SmartLoo/HW/Resources/SmartLooBOM.xlsx

Component | Quantity | Description | Link
PCB:
Capacitor
10uF 0603 Capacitor | 5 | Capacitor | https://www.mouser.com/ProductDetail/963-JMK107BJ106MA-T
.1uF 0603 Capacitor | 4 | Capacitor | https://www.mouser.com/ProductDetail/77-VJ0603Y104MXQCBC
Connector
Xbee Female Connector | 2 | XBee interface connector | https://www.mouser.com/ProductDetail/855-M22-7131042
IC
ATMEGA328P-AU | 1 | Microprocessor | https://www.mouser.com/ProductDetail/556-ATMEGA328P-AUR
MIC5205 | 1 | 3.3V regulator | https://www.mouser.com/ProductDetail/998-MIC5205-3.3YM5TR
TPS61202 | 1 | 5V Switching Regulator | https://www.mouser.com/ProductDetail/595-TPS61202DRCR
Inductor
2.2uH 1210 | 1 | Inductor | https://www.mouser.com/ProductDetail/81-1226AS-H-2R2MP2
Resistor
10k 0603 Resistor | 2 | Resistor | https://www.mouser.com/ProductDetail/755-ESR03EZPJ103
Resonator
8MHz Resonator | 1 | Resonator | https://www.mouser.com/ProductDetail/81-CSTCE8M00GH5C99R0
Sensor Node:
Enclosure
Plastic Enclosure | 1 | Plastic Enclosure | https://www.amazon.com/gp/product/B073Y7FW1Q/ref=oh_aui_detailpage_o02_s00?ie=UTF8&psc=1
Sensors
HC-SR04 | 1 | Ultrasonic Sensor | https://www.amazon.com/Keywish-HC-SR04-Ultrasonic-Duemilanove-Raspberry/dp/B071W9689R?s=hi
Grove Water Sensor | 1 | Grove Water Sensor | https://www.amazon.com/SeeedStudio-Grove-Sensor-Source-BOOOLE/dp/B00VY9W806
Wiring Harness
2x3 Position Male Header | 1 | Male Connector | https://www.digikey.com/product-detail/en/M20-9720345/952-1921-ND/3727888?so=54298428
2x3 Position Female Header | 1 | Female Connector | https://www.digikey.com/product-detail/en/PPPC032LFBN-RC/S7106-ND/810243?so=54298428
6 Conductor 24 AWG Wiring | 1' | Wiring Connector | https://www.digikey.com/product-detail/en/30-00507/T1346-5-ND/6245014?so=54298428
XBee
XBee S2C | 1 | XBee S2C Radio Module | https://www.digikey.com/product-detail/en/digi-international/XB24CAWIT-001/602-1891-ND/6010100
