SmartLoo/HW/Resources/EAGLE/LooSensorNodeV2/LooSensorNodeV2_Schematic/LooSensorNodeV2_Page1.pdf

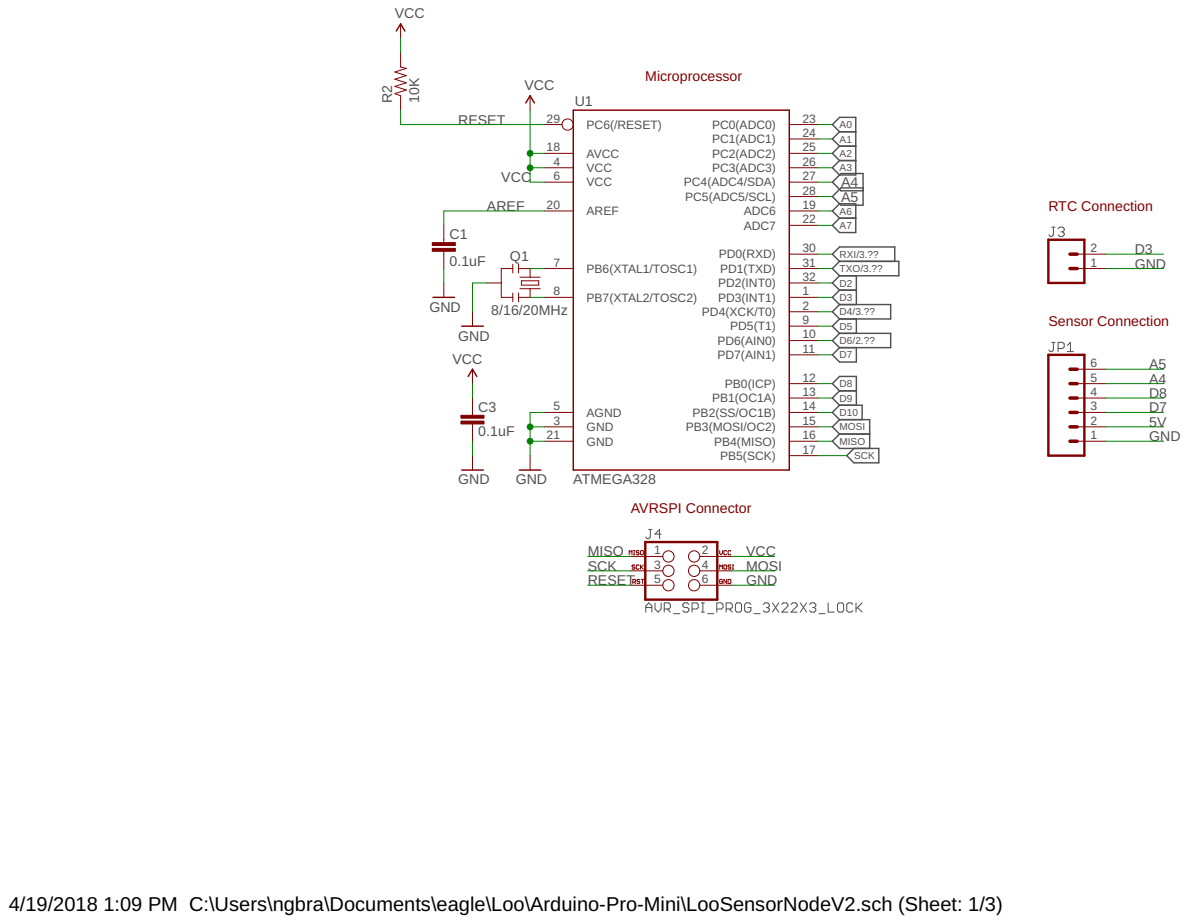
[picture p4: page 1]

4/19/2018 1:09 PM C:\Users\ngbra\Documents\eagle\Loo\Arduino-Pro-Mini\LooSensorNodeV2.sch (Sheet: 1/3)
