SmartLoo/HW/Resources/EAGLE/LooSensorNodeV2/LooSensorNodeV2_Schematic/LooSensorNodeV2_Page2.pdf

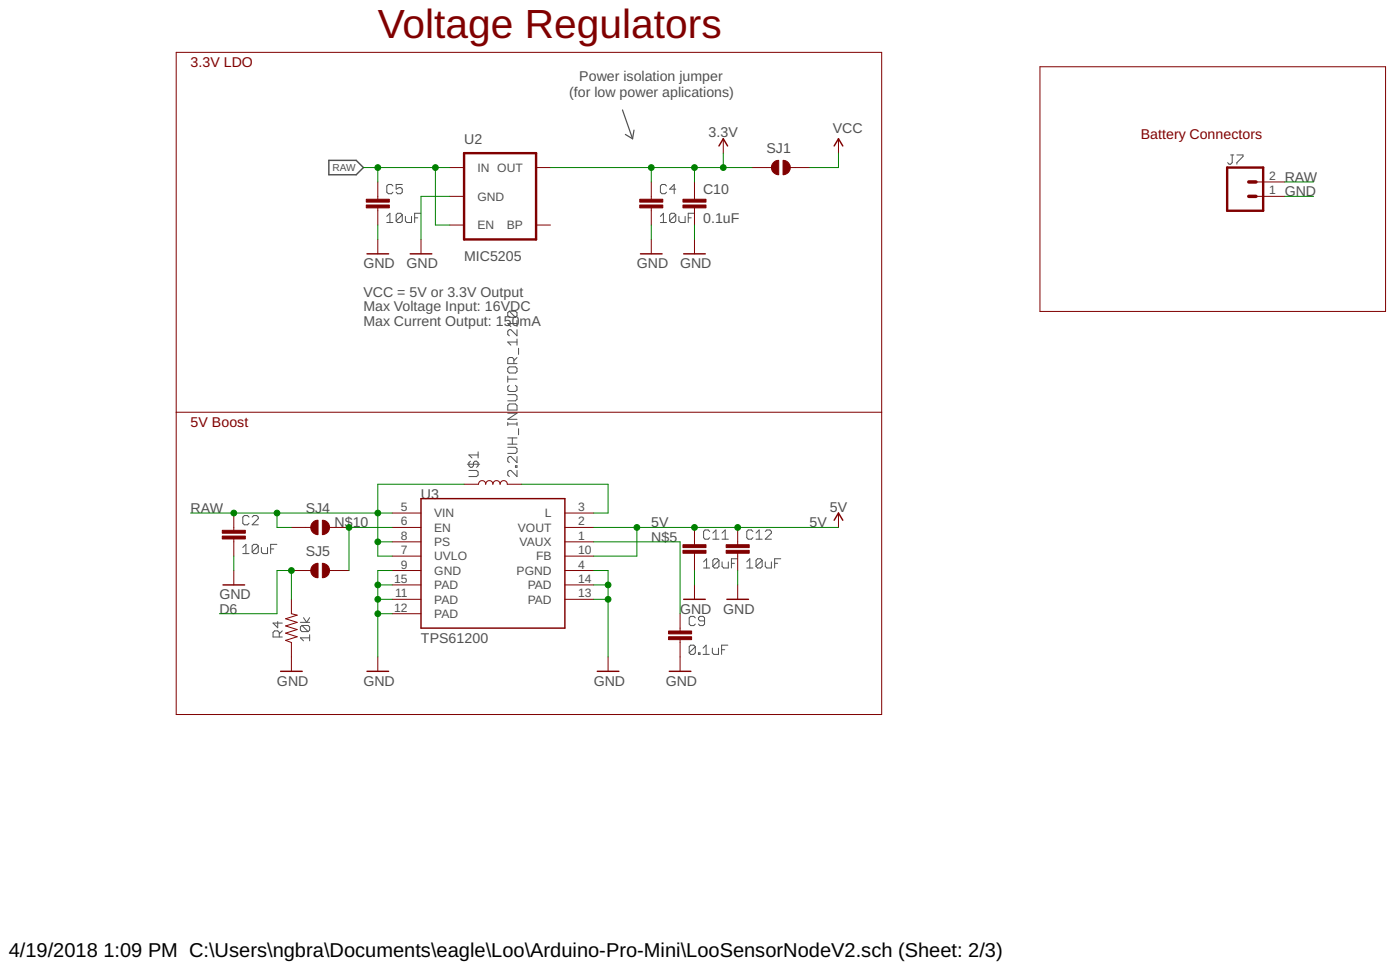
[picture p5: page 1]

Power isolation jumper
(for low power aplications)

GND GND MIC5205 GND GND

4/19/2018 1:09 PM C:\Users\ngbra\Documents\eagle\Loo\Arduino-Pro-Mini\LooSensorNodeV2.sch (Sheet: 2/3)
