SmartLoo/HW/Resources/EAGLE/LooSensorNodeV2/LooSensorNodeV2_Layout.pdf

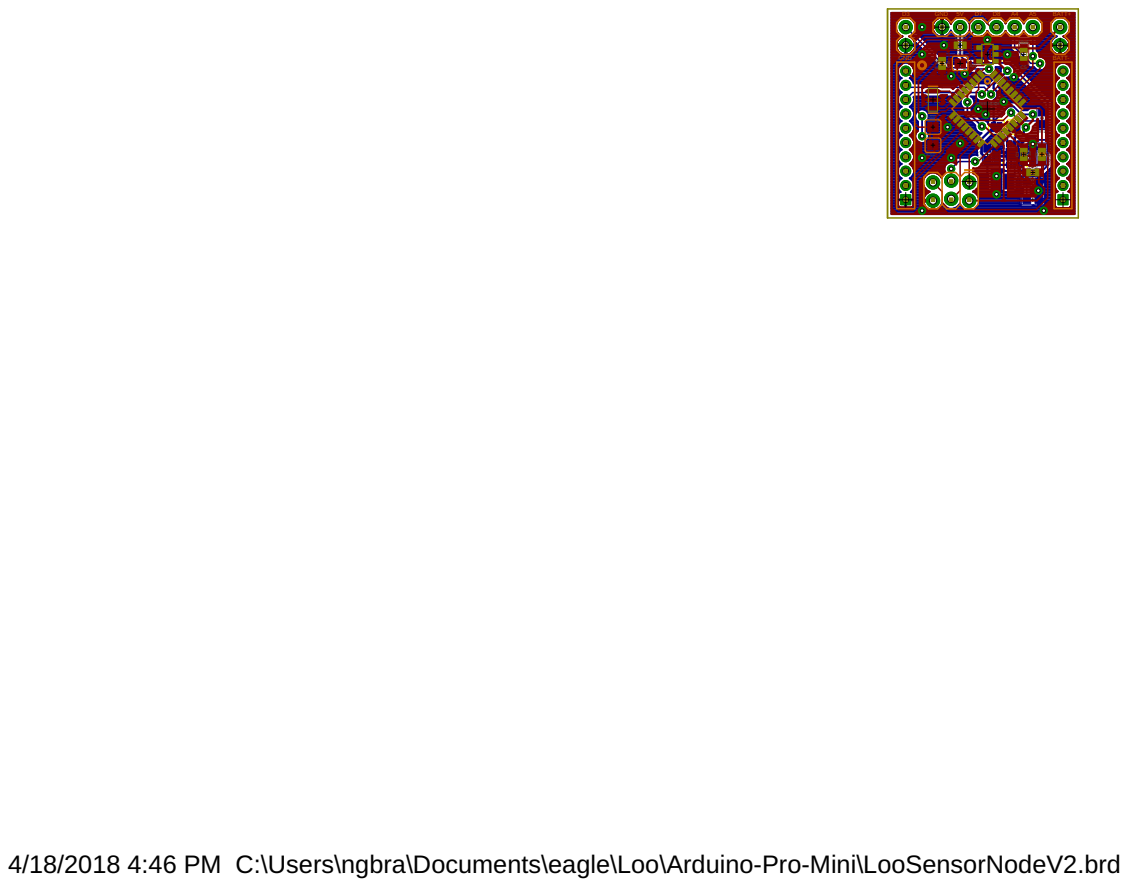
[picture p6: page 1]

4/18/2018 4:46 PM C:\Users\ngbra\Documents\eagle\Loo\Arduino-Pro-Mini\LooSensorNodeV2.brd
