SmartLoo/HW/Resources/EAGLE/LooSensorNodeV0/LooSensorNodeV0Schematic.pdf

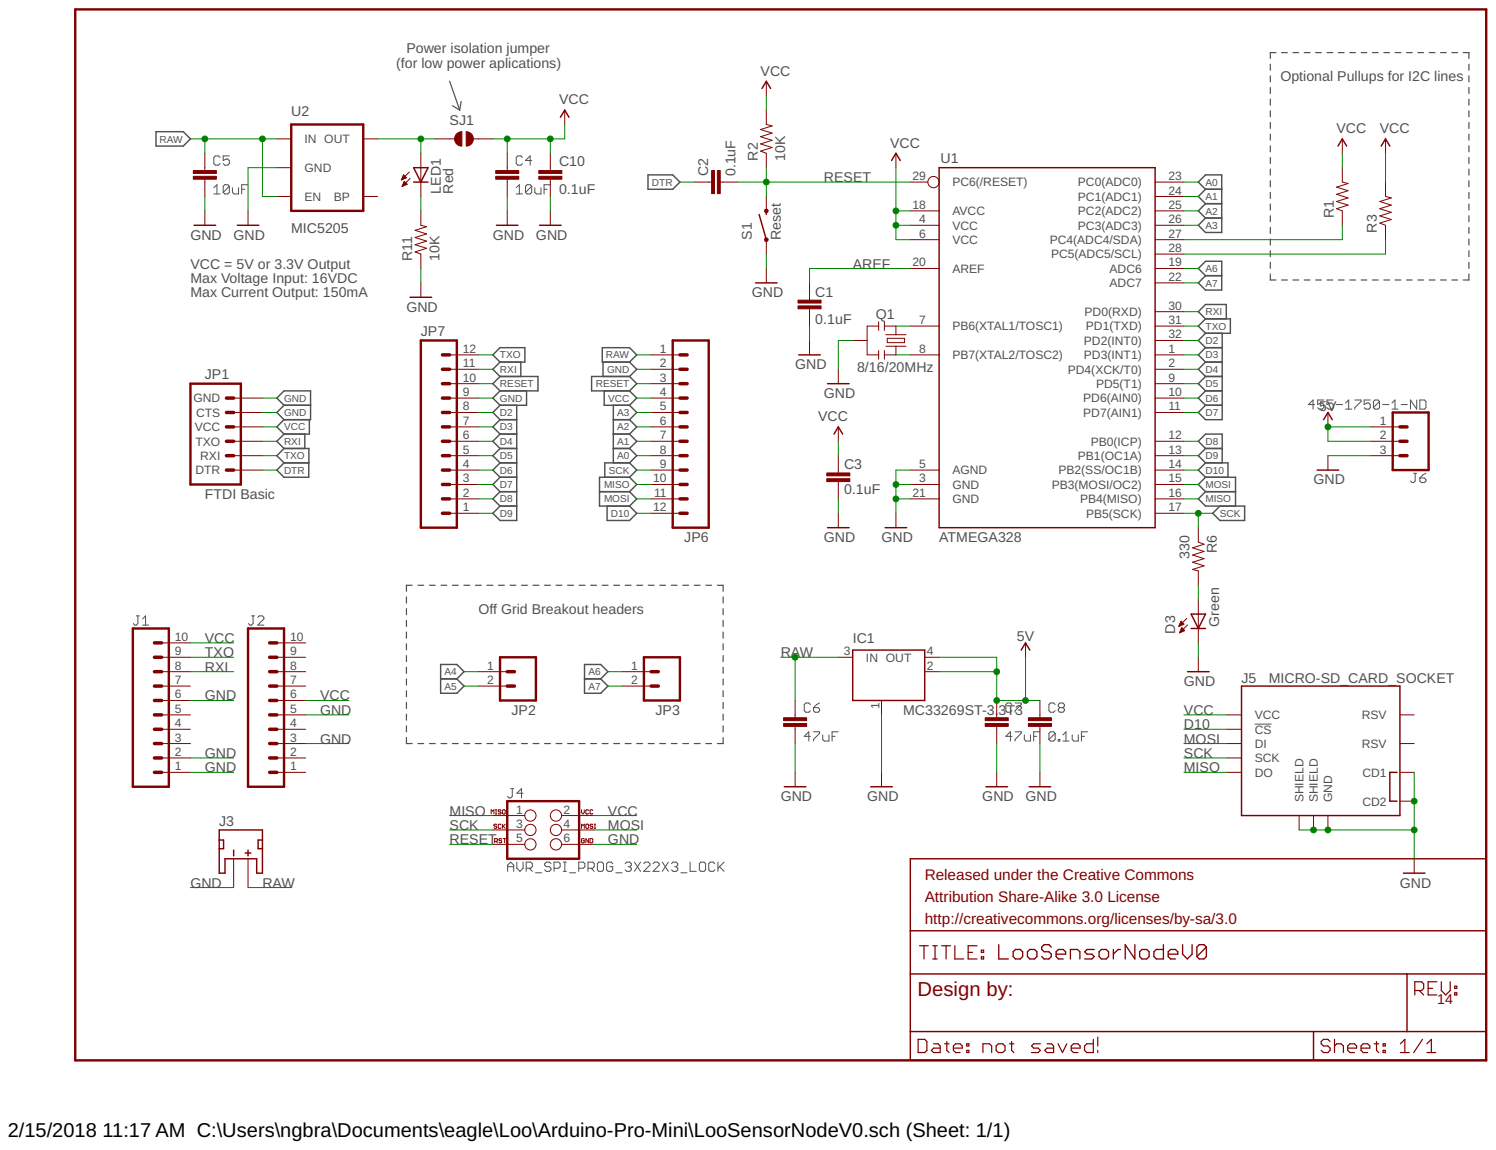
[picture p7: page 1]

Power isolation jumper
(for low power aplications)

Optional Pullups for I2C lines

Off Grid Breakout headers

Released under the Creative Commons Attribution Share-Alike 3.0 License

http://creativecommons.org/licenses/by-sa/3.0

2/15/2018 11:17 AM C:\Users\ngbra\Documents\eagle\Loo\Arduino-Pro-Mini\LooSensorNodeV0.sch (Sheet: 1/1)
