SmartLoo/HW/Resources/EAGLE/LooSensorNodeV1/LooSensorNodeV1Schematic/LooSensorNodeV1P1.pdf

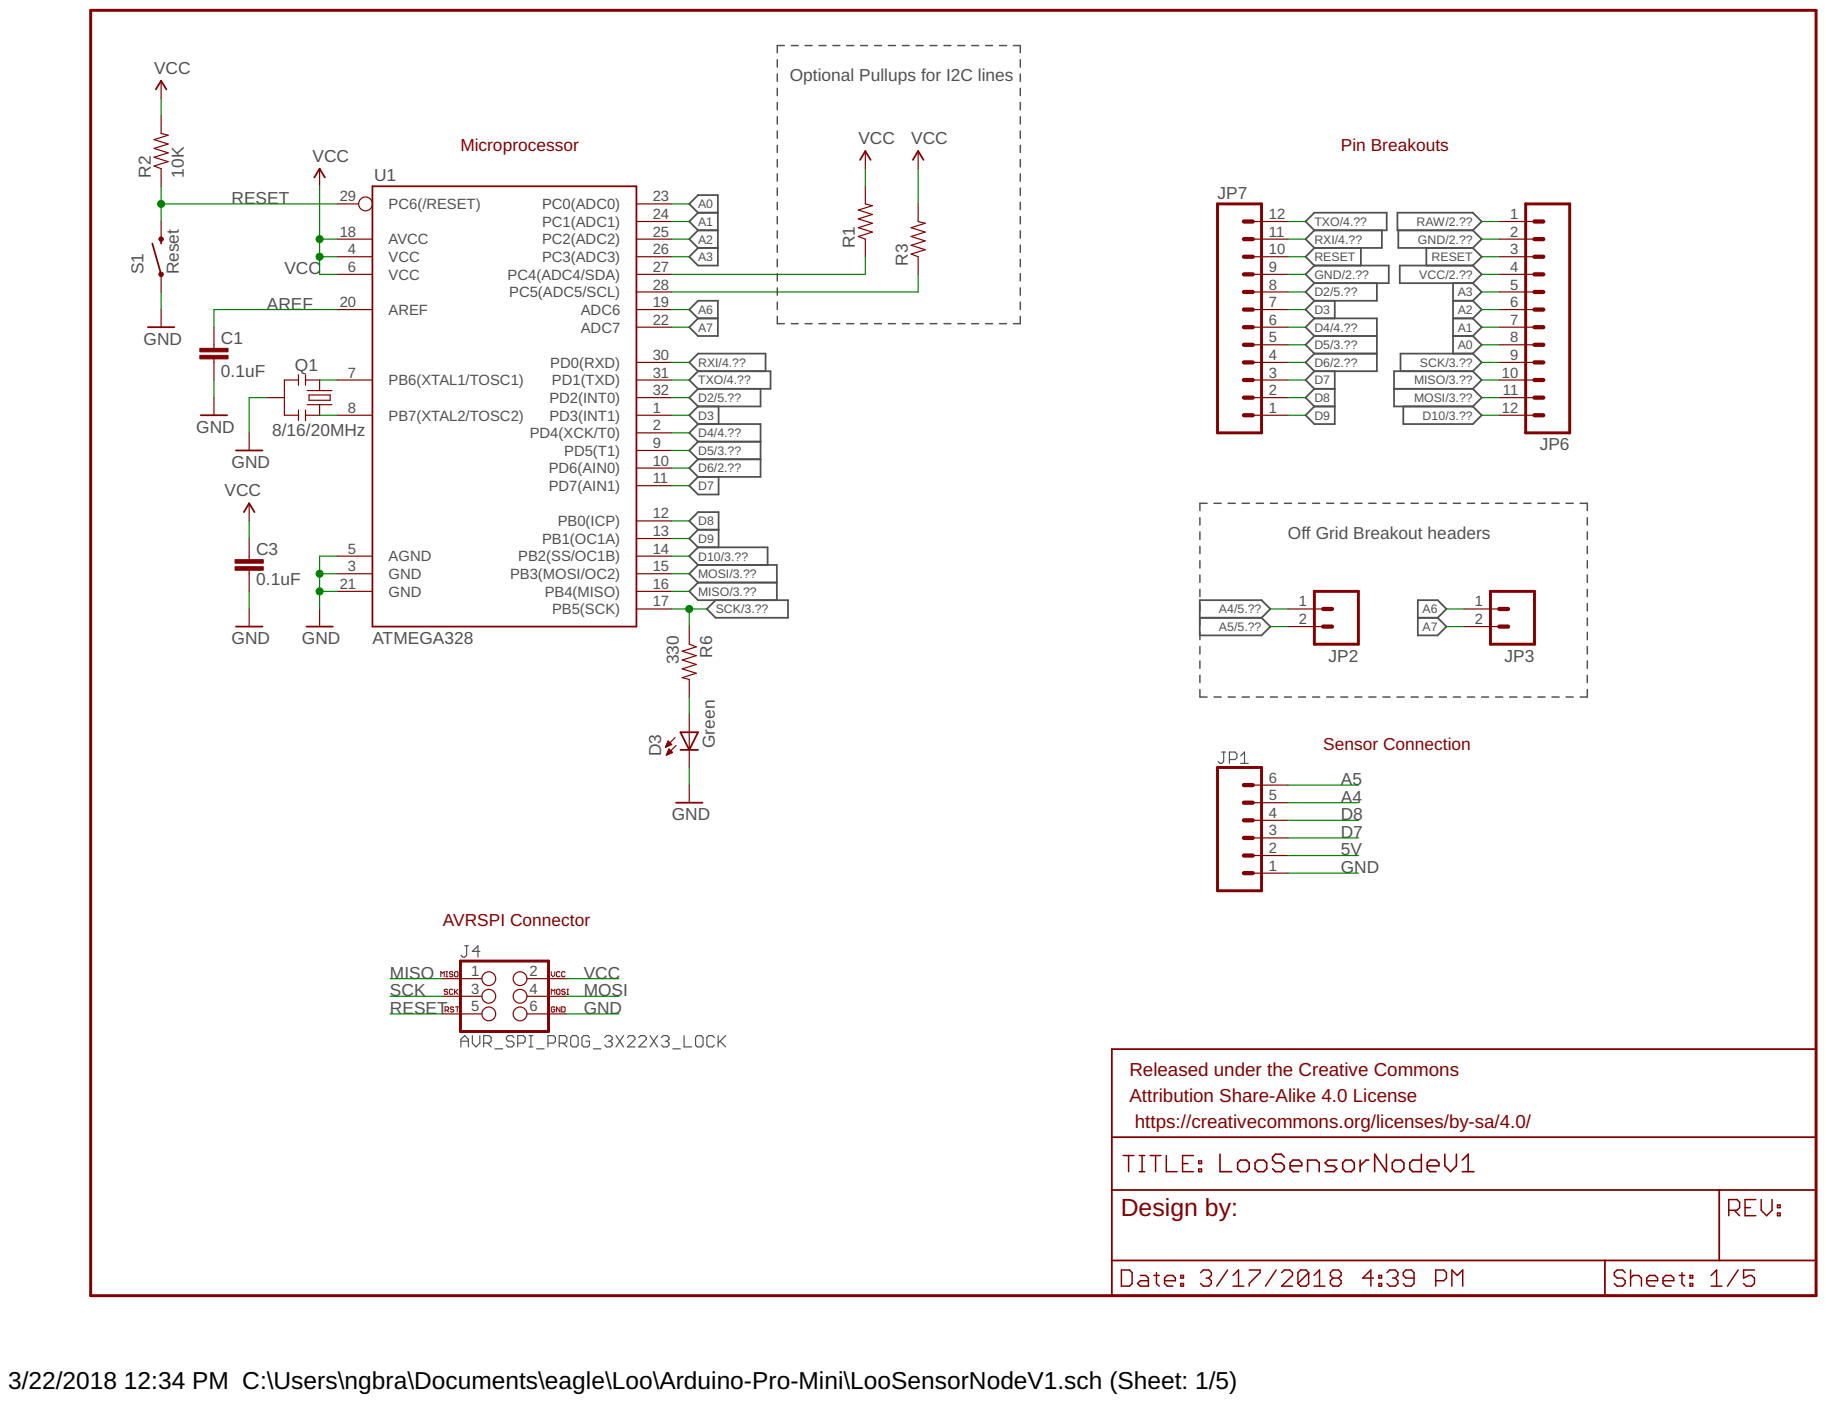
[picture p8: page 1]

Optional Pullups for I2C lines

Off Grid Breakout headers

Released under the Creative Commons Attribution Share-Alike 4.0 License

https://creativecommons.org/licenses/by-sa/4.0/

3/22/2018 12:34 PM C:\Users\ngbra\Documents\eagle\Loo\Arduino-Pro-Mini\LooSensorNodeV1.sch (Sheet: 1/5)
