SmartLoo/HW/Resources/EAGLE/LooSensorNodeV1/LooSensorNodeV1Schematic/LooSensorNodeV1P2.pdf

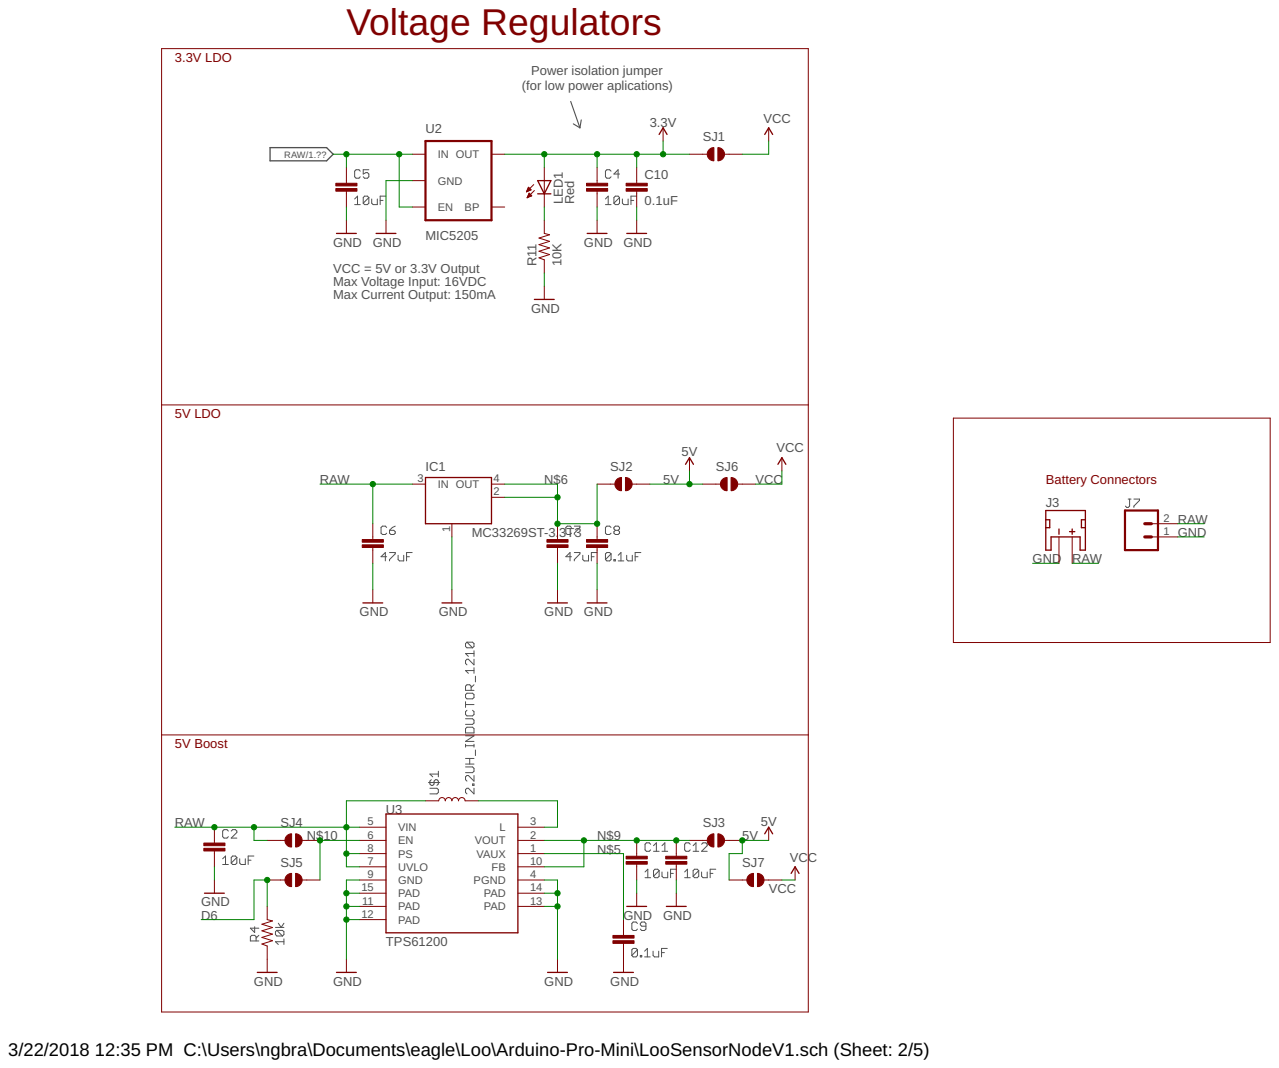
[picture p9: page 1]

Power isolation jumper
(for low power aplications)

3/22/2018 12:35 PM C:\Users\ngbra\Documents\eagle\Loo\Arduino-Pro-Mini\LooSensorNodeV1.sch (Sheet: 2/5)
