SmartLoo/HW/Resources/EAGLE/LooSensorNodeV0/LooSensorNodeV0Layout.pdf

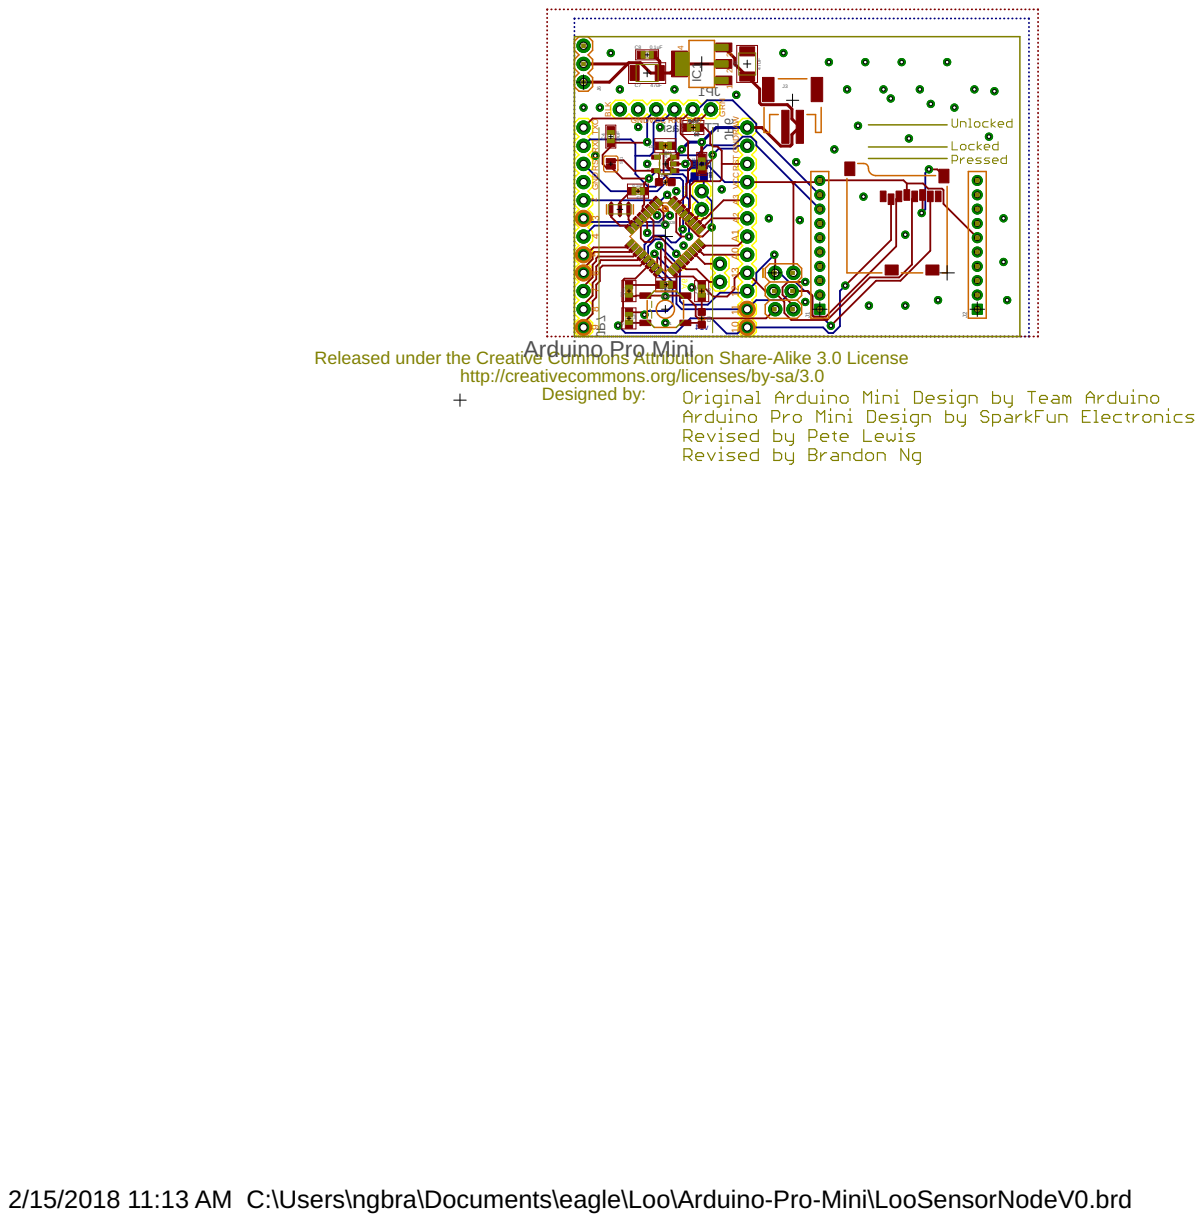
[picture p10: page 1]

Reset 9 8 7 6 5 4 3 2 GNDRST RXI TXO

RAW GND RST VCC A3 A2 A1 A0 13 12 11 10

Released under the Creative Commons Attribution Share-Alike 3.0 License

http://creativecommons.org/licenses/by-sa/3.0

2/15/2018 11:13 AM C:\Users\ngbra\Documents\eagle\Loo\Arduino-Pro-Mini\LooSensorNodeV0.brd
