SmartLoo/HW/Resources/EAGLE/LooSensorNodeV2/LooSensorNodeV2.brd

## EAGLE design Resources/EAGLE/LooSensorNodeV2/LooSensorNodeV2.brd (2018-04-29)

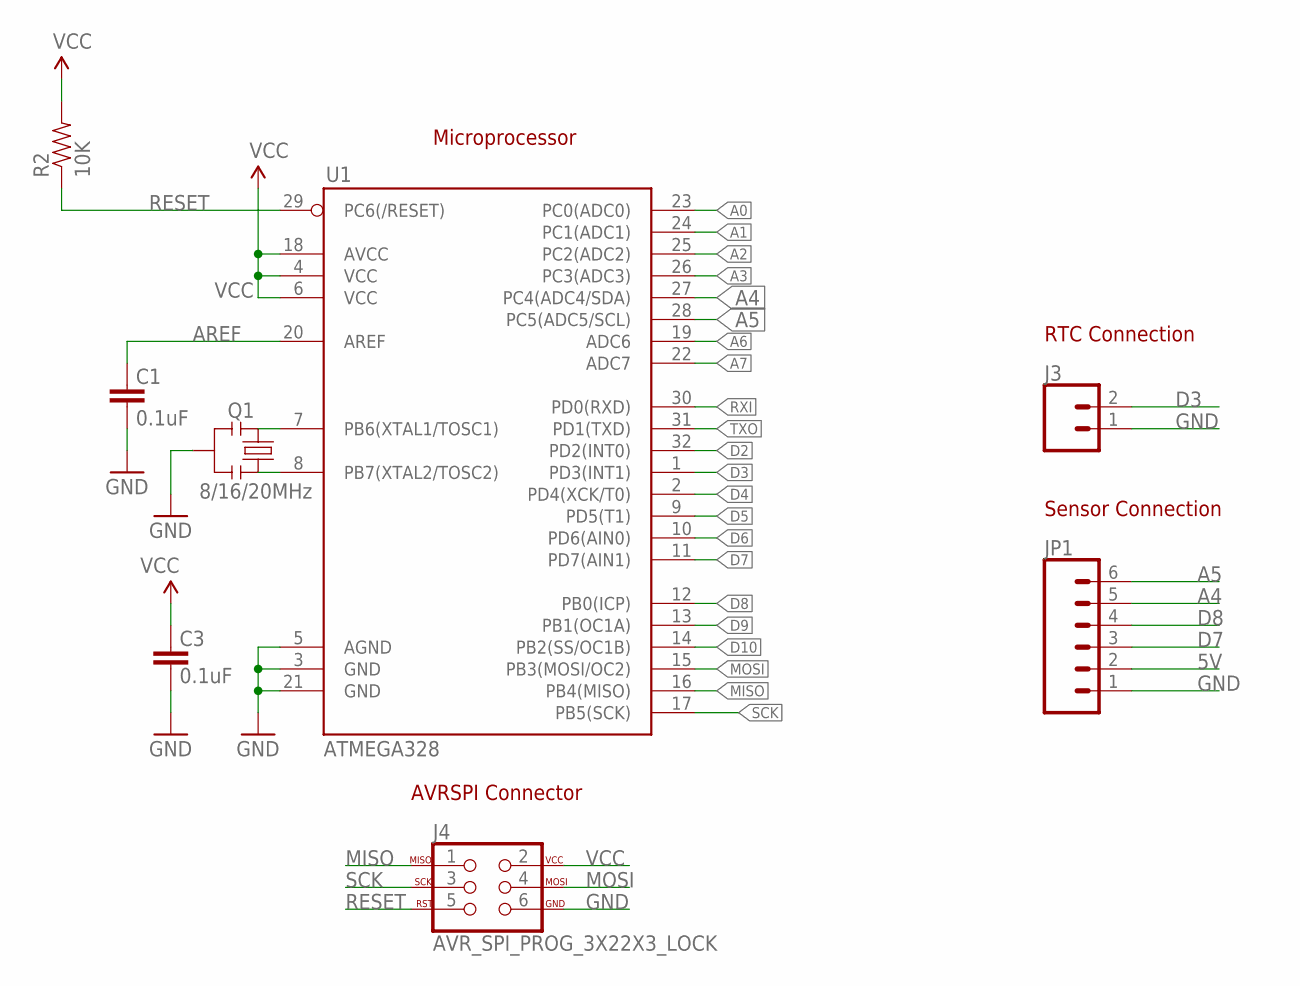
[picture p11: schematic LooSensorNodeV2.sch, sheet 1]

Parts:
C1, C3: 0.1uF; 0603-CAP
J3: CONN_02; 1X02
J4: AVR_SPI_PROG_3X22X3_LOCK; 2X3_LOCK
JP1: CONN_06SILK_FEMALE_PTH; 1X06
Q1: 8/16/20MHz; RESONATOR-SMD-1:1
R2: 10K; 0603-RES
U1: ATMEGA328; TQFP32-08

Connections:
5V: JP1.2; also elsewhere on the board
A0: U1.23 (PC0(ADC0))
A1: U1.24 (PC1(ADC1))
A2: U1.25 (PC2(ADC2))
A3: U1.26 (PC3(ADC3))
A4: JP1.5, U1.27 (PC4(ADC4/SDA))
A5: JP1.6, U1.28 (PC5(ADC5/SCL))
A6: U1.19 (ADC6)
A7: U1.22 (ADC7)
AREF: C1.2, U1.20 (AREF)
D2: U1.32 (PD2(INT0))
D3: J3.2, U1.1 (PD3(INT1))
D4: U1.2 (PD4(XCK/T0)); also elsewhere on the board
D5: U1.9 (PD5(T1))
D6: U1.10 (PD6(AIN0)); also elsewhere on the board
D7: JP1.3, U1.11 (PD7(AIN1))
D8: JP1.4, U1.12 (PB0(ICP))
D9: U1.13 (PB1(OC1A))
D10: U1.14 (PB2(SS/OC1B))
GND: C1.1, C3.1, J3.1, J4.6, JP1.1, Q1.2, U1.3 (GND), U1.5 (AGND), U1.21 (GND); also elsewhere on the board
MISO: J4.1, U1.16 (PB4(MISO))
MOSI: J4.4, U1.15 (PB3(MOSI/OC2))
unnamed: Q1.3, U1.8 (PB7(XTAL2/TOSC2))
unnamed: Q1.1, U1.7 (PB6(XTAL1/TOSC1))
RESET: J4.5, R2.1, U1.29 (PC6(/RESET))
RXI: U1.30 (PD0(RXD)); also elsewhere on the board
SCK: J4.3, U1.17 (PB5(SCK))
TXO: U1.31 (PD1(TXD)); also elsewhere on the board
VCC: C3.2, J4.2, R2.2, U1.4 (VCC), U1.6 (VCC), U1.18 (AVCC); also elsewhere on the board

Notes on the sheet:
AVRSPI Connector
Microprocessor
Sensor Connection
RTC Connection

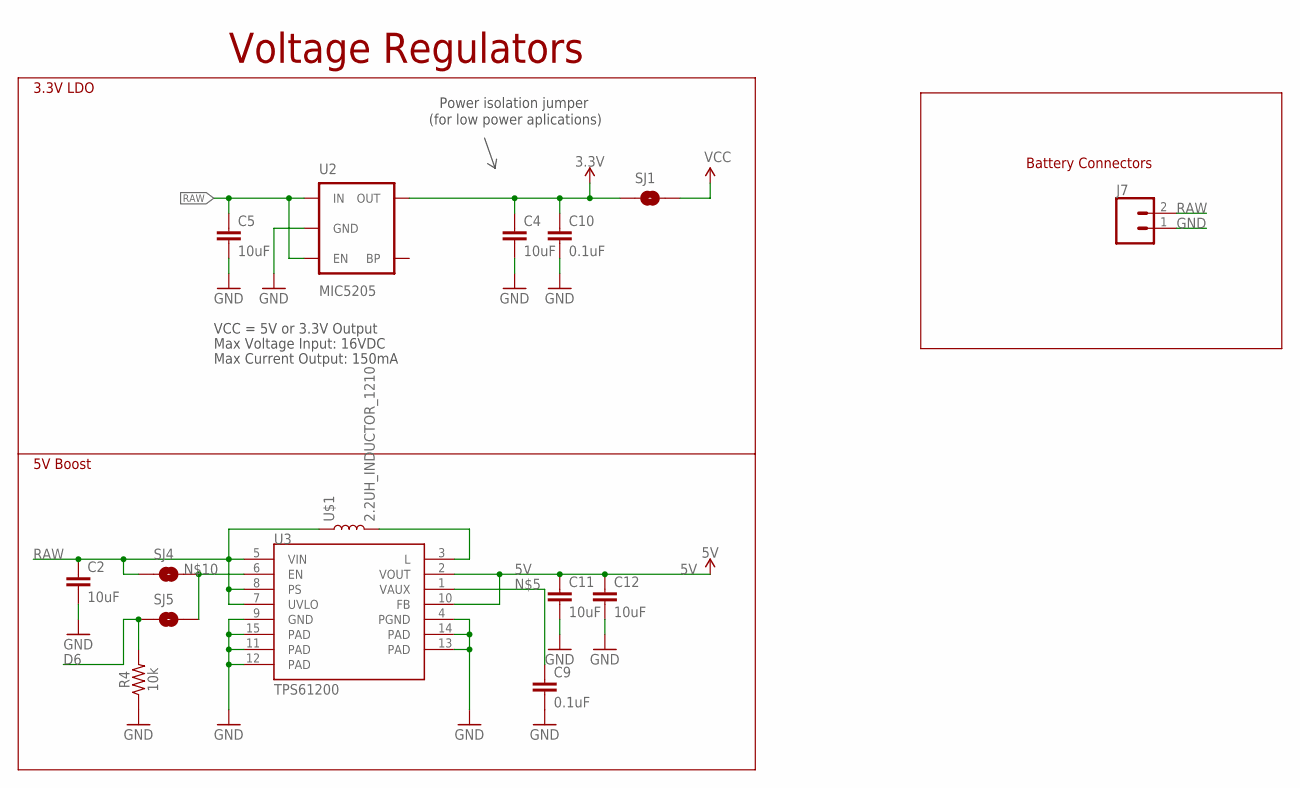
[picture p12: schematic LooSensorNodeV2.sch, sheet 2]

Parts:
C2, C4, C5, C11, C12: 10uF; 0603
C9: 0.1uF; 0603
C10: 0.1uF; 0603-CAP
J7: CONN_02; 1X02
R4: 10k; 0603
SJ1, SJ4, SJ5: SOLDERJUMPERNC; SJ_2S
U2: MIC5205; SOT23-5
U3: TPS61200; QFN-10_PAD
U$1: 2.2UH_INDUCTOR_1210; 1210

Connections:
3.3V: C4.1, C10.1, SJ1.1, U2.5 (OUT); also elsewhere on the board
5V: C11.1, C12.1, U3.2 (VOUT), U3.10 (FB); also elsewhere on the board
D6: R4.2, SJ5.1; also elsewhere on the board
GND: C2.2, C4.2, C5.2, C9.2, C10.2, C11.2, C12.2, J7.1, R4.1, U2.2 (GND), U3.4 (PGND), U3.9 (GND), U3.11 (PAD), U3.12 (PAD), U3.13 (PAD), U3.14 (PAD), U3.15 (PAD); also elsewhere on the board
unnamed: C9.1, U3.1 (VAUX)
unnamed: U3.3 (L), U$1.2
unnamed: SJ4.2, SJ5.2, U3.6 (EN)
RAW: C2.1, C5.1, J7.2, SJ4.1, U2.1 (IN), U2.3 (EN), U3.5 (VIN), U3.7 (UVLO), U3.8 (PS), U$1.1
VCC: SJ1.2; also elsewhere on the board

Notes on the sheet:
Max Voltage Input: 16VDC
Max Current Output: 150mA
VCC = 5V or 3.3V Output
Power isolation jumper
(for low power aplications)
3.3V LDO
5V Boost
Voltage Regulators
Battery Connectors

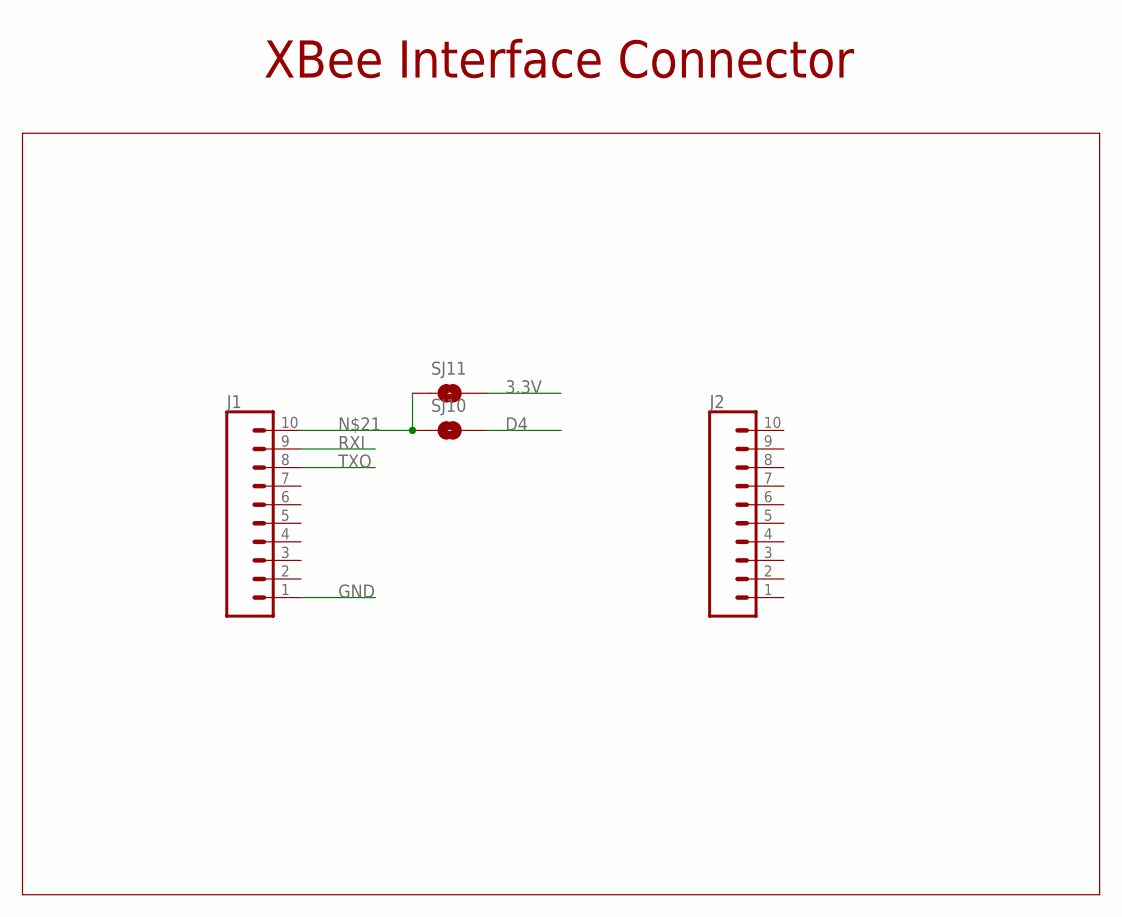
[picture p13: schematic LooSensorNodeV2.sch, sheet 3]

Parts:
J1, J2: CONN_102MM; 1X10-2MM
SJ10, SJ11: SOLDERJUMPERNC; SJ_2S

Connections:
3.3V: SJ11.2; also elsewhere on the board
D4: SJ10.2; also elsewhere on the board
GND: J1.1; also elsewhere on the board
unnamed: J1.10, SJ10.1, SJ11.1
RXI: J1.9; also elsewhere on the board
TXO: J1.8; also elsewhere on the board

Notes on the sheet:
XBee Interface Connector

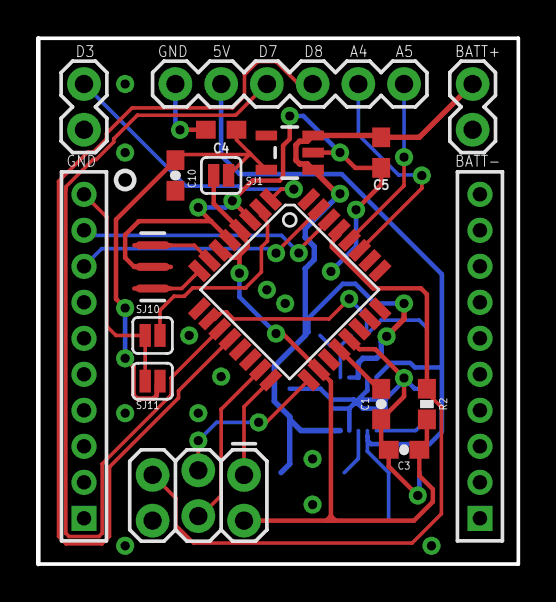
[picture p14: board LooSensorNodeV2.brd from above]

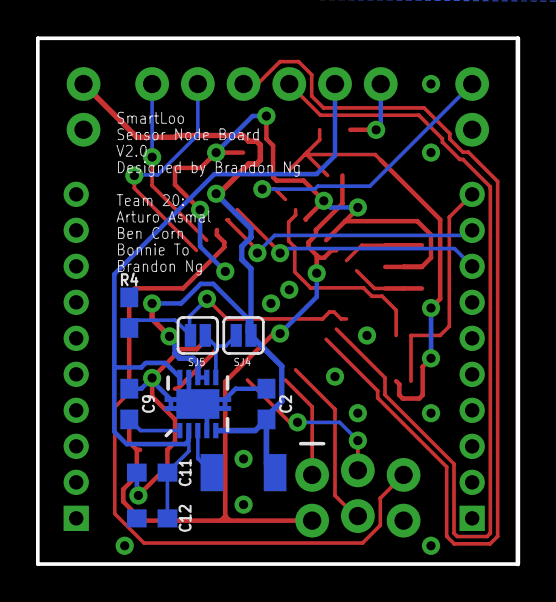
[picture p15: board LooSensorNodeV2.brd from below]

Board: 2 copper layers, 26.7 x 29.2 mm, 27 parts (9 on the bottom side), 25 nets.
