SmartLoo/HW/Resources/EAGLE/LooSensorNodeV1/LooSensorNodeV1.brd

## EAGLE design Resources/EAGLE/LooSensorNodeV1/LooSensorNodeV1.brd (2018-04-29, an earlier design)

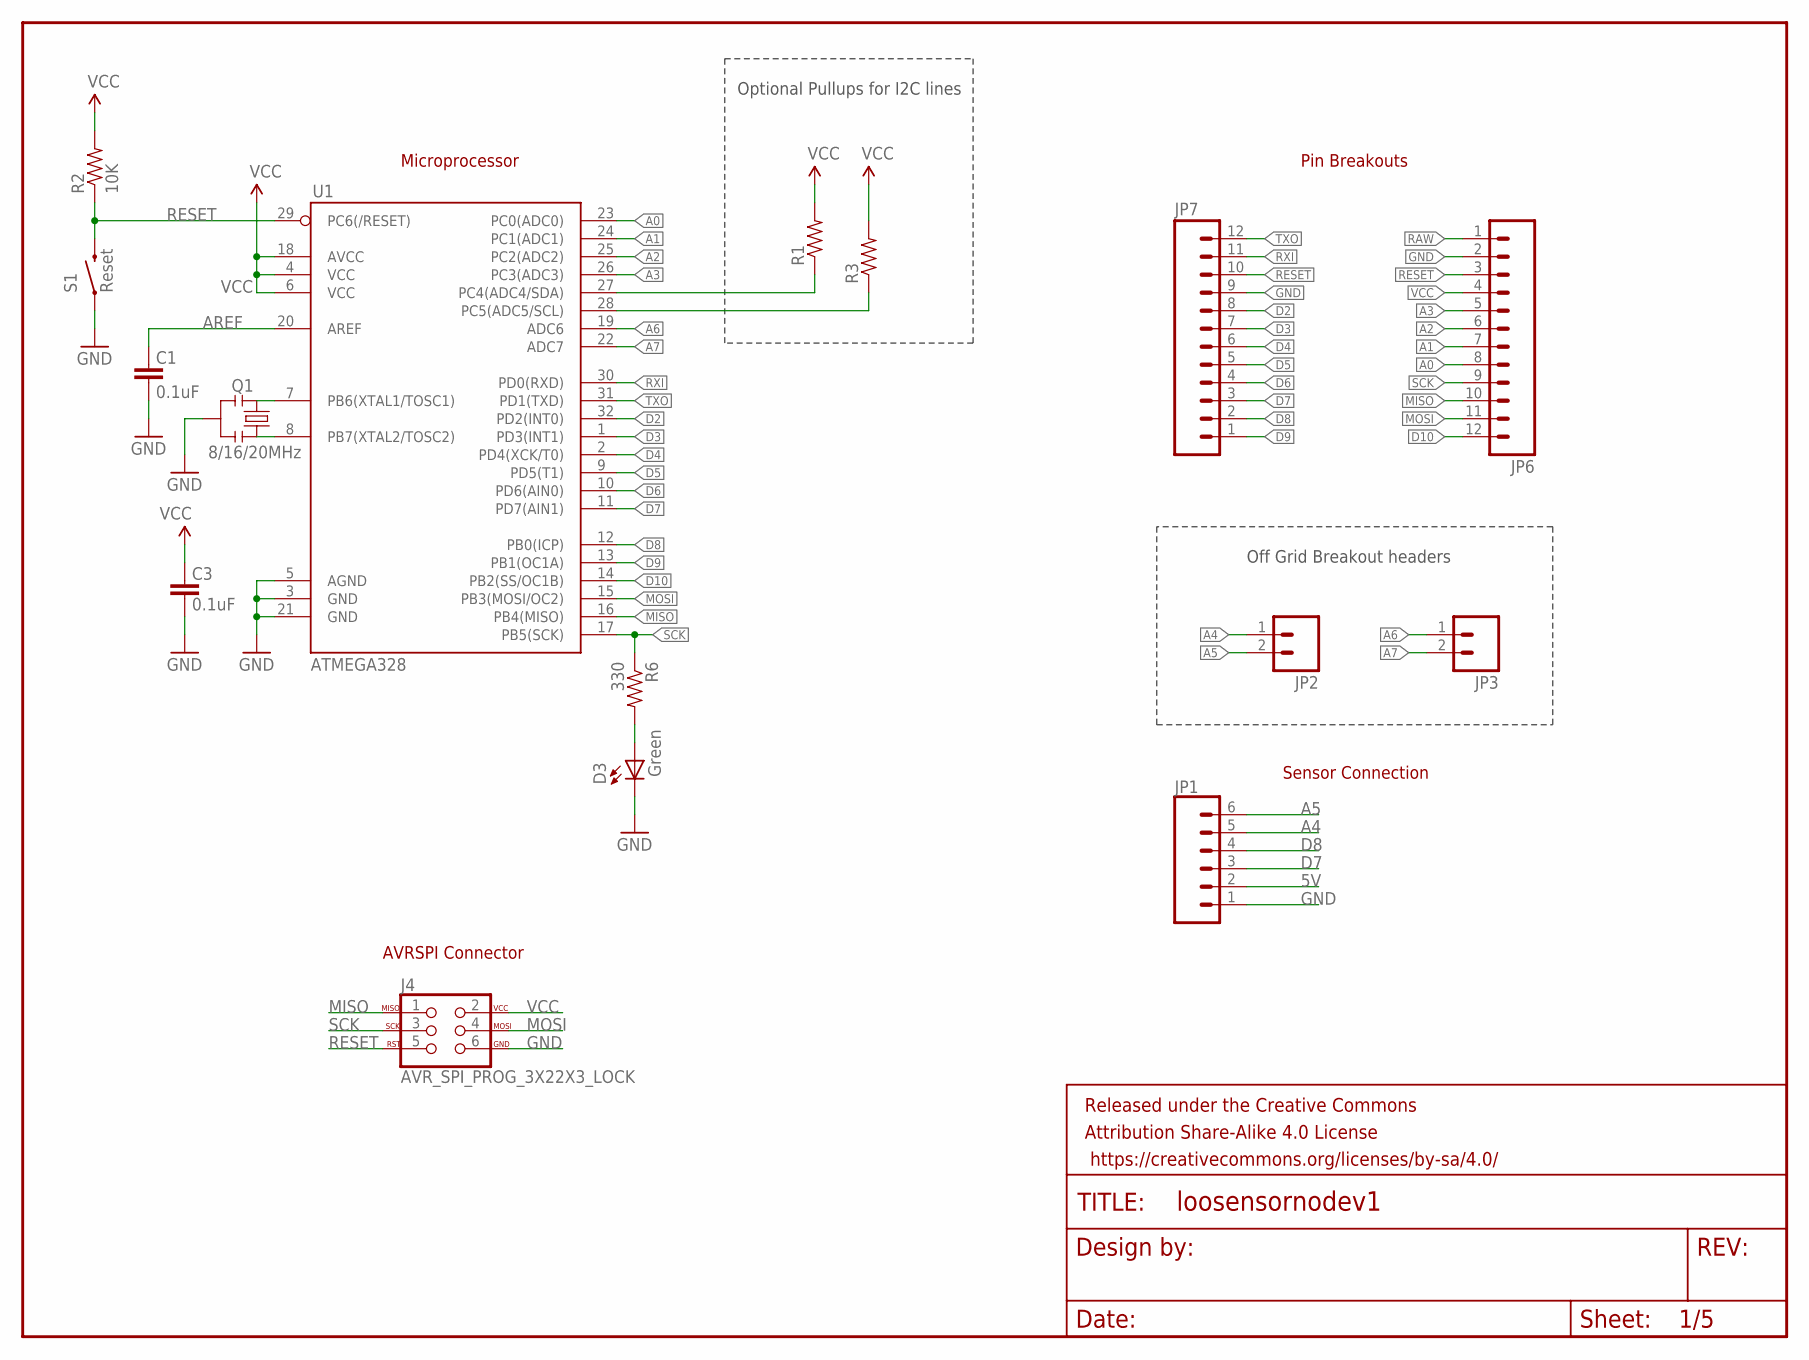
[picture p16: schematic LooSensorNodeV1.sch, sheet 1]

Parts:
C1, C3: 0.1uF; 0603-CAP
D3: Green; 0603-LED-ALT1
FRAME1: FRAME-LETTER; CREATIVE_COMMONS
J4: AVR_SPI_PROG_3X22X3_LOCK; 2X3_LOCK
JP1: CONN_06SILK_FEMALE_PTH; 1X06
JP2, JP3: M02PTH; 1X02
JP6, JP7: M12PTH; 1X12
Q1: 8/16/20MHz; RESONATOR-SMD-1:1
R1, R3: RESISTOR0603-RES; 0603-RES
R2: 10K; 0603-RES
R6: 330; 0603-RES
S1: Reset; TACTILE-SWITCH-SMD-ALT01
U1: ATMEGA328; TQFP32-08

Connections:
5V: JP1.2; also elsewhere on the board
A0: JP6.8, U1.23 (PC0(ADC0))
A1: JP6.7, U1.24 (PC1(ADC1))
A2: JP6.6, U1.25 (PC2(ADC2))
A3: JP6.5, U1.26 (PC3(ADC3))
A4: JP1.5, JP2.1, R1.1, U1.27 (PC4(ADC4/SDA)); also elsewhere on the board
A5: JP1.6, JP2.2, R3.1, U1.28 (PC5(ADC5/SCL)); also elsewhere on the board
A6: JP3.1, U1.19 (ADC6)
A7: JP3.2, U1.22 (ADC7)
AREF: C1.2, U1.20 (AREF)
D2: JP7.8, U1.32 (PD2(INT0)); also elsewhere on the board
D3: JP7.7, U1.1 (PD3(INT1))
D4: JP7.6, U1.2 (PD4(XCK/T0)); also elsewhere on the board
D5: JP7.5, U1.9 (PD5(T1)); also elsewhere on the board
D6: JP7.4, U1.10 (PD6(AIN0)); also elsewhere on the board
D7: JP1.3, JP7.3, U1.11 (PD7(AIN1))
D8: JP1.4, JP7.2, U1.12 (PB0(ICP))
D9: JP7.1, U1.13 (PB1(OC1A))
D10: JP6.12, U1.14 (PB2(SS/OC1B)); also elsewhere on the board
GND: C1.1, C3.1, D3.C, J4.6, JP1.1, JP6.2, JP7.9, Q1.2, S1.1, S1.2 (1), U1.3 (GND), U1.5 (AGND), U1.21 (GND); also elsewhere on the board
MISO: J4.1, JP6.10, U1.16 (PB4(MISO)); also elsewhere on the board
MOSI: J4.4, JP6.11, U1.15 (PB3(MOSI/OC2)); also elsewhere on the board
unnamed: Q1.3, U1.8 (PB7(XTAL2/TOSC2))
unnamed: Q1.1, U1.7 (PB6(XTAL1/TOSC1))
unnamed: D3.A, R6.2
RAW: JP6.1; also elsewhere on the board
RESET: J4.5, JP6.3, JP7.10, R2.1, S1.3 (2), S1.4 (2), U1.29 (PC6(/RESET))
RXI: JP7.11, U1.30 (PD0(RXD)); also elsewhere on the board
SCK: J4.3, JP6.9, R6.1, U1.17 (PB5(SCK)); also elsewhere on the board
TXO: JP7.12, U1.31 (PD1(TXD)); also elsewhere on the board
VCC: C3.2, J4.2, JP6.4, R1.2, R2.2, R3.2, U1.4 (VCC), U1.6 (VCC), U1.18 (AVCC); also elsewhere on the board

Notes on the sheet:
Optional Pullups for I2C lines
Off Grid Breakout headers
AVRSPI Connector
Pin Breakouts
Microprocessor
Sensor Connection

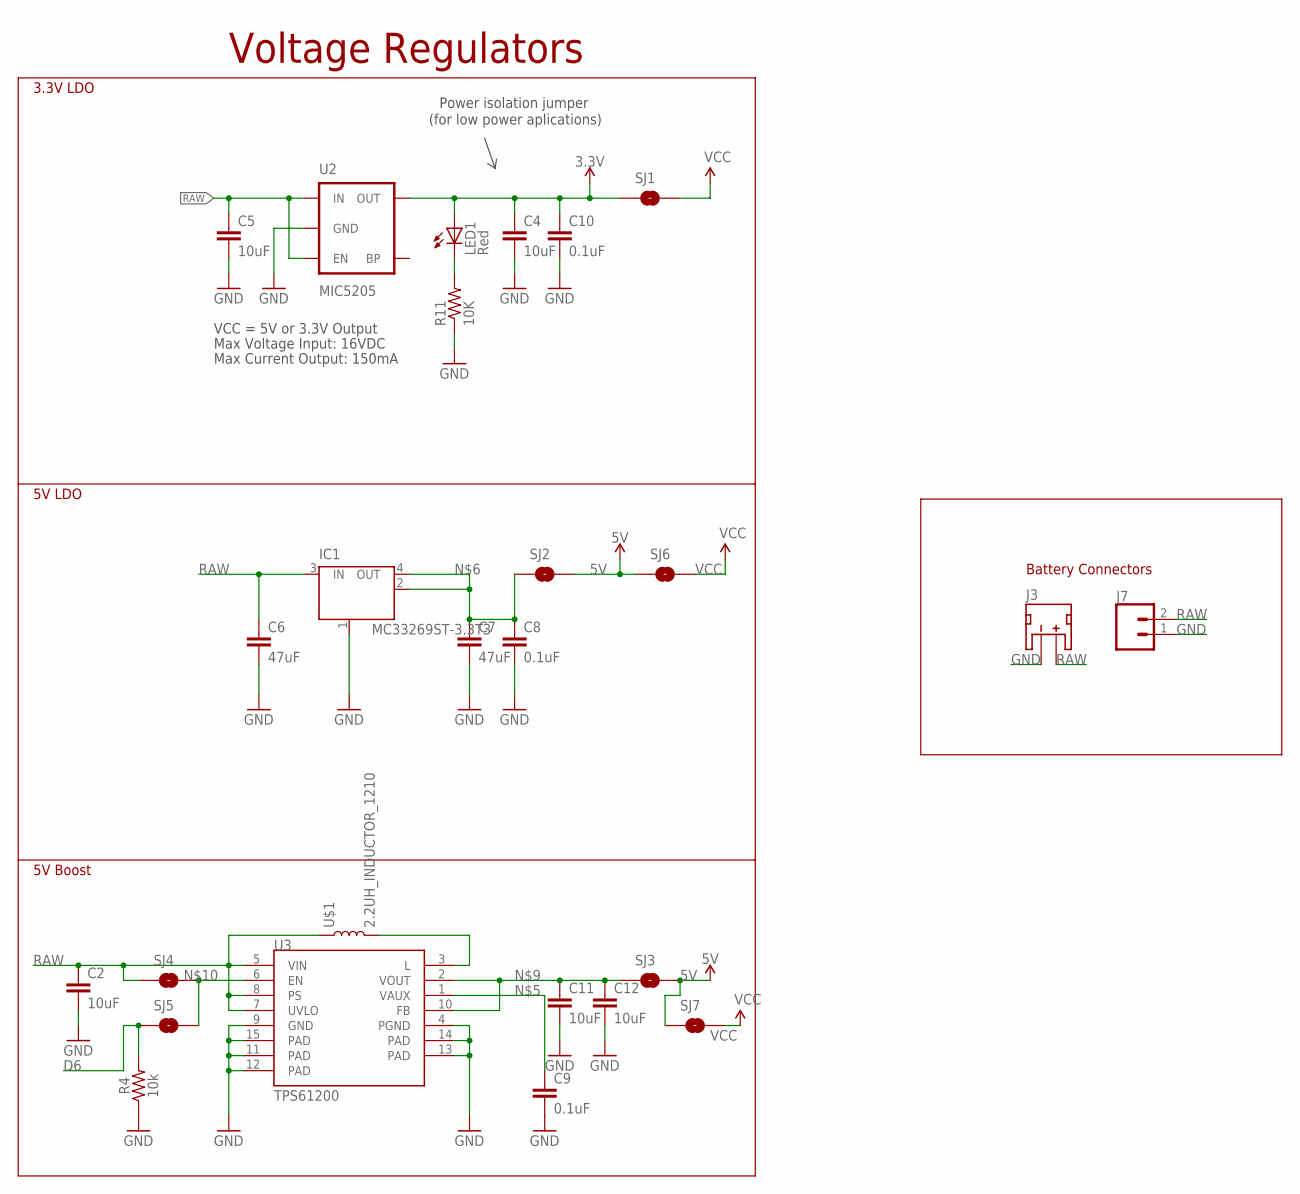
[picture p17: schematic LooSensorNodeV1.sch, sheet 2]

Parts:
C2, C4, C5, C11, C12: 10uF; 0603
C6, C7: 47uF; 1210
C8, C9: 0.1uF; 0603
C10: 0.1uF; 0603-CAP
IC1: MC33269ST-3.3T3; SOT223
J3: JST_2MM_MALE; JST-2-SMD
J7: CONN_02; 1X02
LED1: Red; 0603-LED-ALT1
R4: 10k; 0603
R11: 10K; 0603-RES
SJ1, SJ2, SJ3, SJ4, SJ5, SJ6, SJ7: SOLDERJUMPERNC; SJ_2S
U2: MIC5205; SOT23-5
U3: TPS61200; QFN-10_PAD
U$1: 2.2UH_INDUCTOR_1210; 1210

Connections:
3.3V: C4.1, C10.1, LED1.A, SJ1.1, U2.5 (OUT); also elsewhere on the board
5V: SJ2.2, SJ3.2, SJ6.1, SJ7.1; also elsewhere on the board
D6: R4.2, SJ5.1; also elsewhere on the board
GND: C2.2, C4.2, C5.2, C6.2, C7.2, C8.2, C9.2, C10.2, C11.2, C12.2, IC1.1 (GND/ADJ), J3.1 (-), J7.1, R4.1, R11.1, U2.2 (GND), U3.4 (PGND), U3.9 (GND), U3.11 (PAD), U3.12 (PAD), U3.13 (PAD), U3.14 (PAD), U3.15 (PAD); also elsewhere on the board
unnamed: LED1.C, R11.2
unnamed: C9.1, U3.1 (VAUX)
unnamed: C7.1, C8.1, IC1.2 (OUT), IC1.4 (OUT), SJ2.1
unnamed: U3.3 (L), U$1.2
unnamed: C11.1, C12.1, SJ3.1, U3.2 (VOUT), U3.10 (FB)
unnamed: SJ4.2, SJ5.2, U3.6 (EN)
RAW: C2.1, C5.1, C6.1, IC1.3 (IN), J3.2 (+), J7.2, SJ4.1, U2.1 (IN), U2.3 (EN), U3.5 (VIN), U3.7 (UVLO), U3.8 (PS), U$1.1; also elsewhere on the board
VCC: SJ1.2, SJ6.2, SJ7.2; also elsewhere on the board

Notes on the sheet:
Max Voltage Input: 16VDC
Max Current Output: 150mA
VCC = 5V or 3.3V Output
Power isolation jumper
(for low power aplications)
3.3V LDO
5V LDO
5V Boost
Voltage Regulators
Battery Connectors

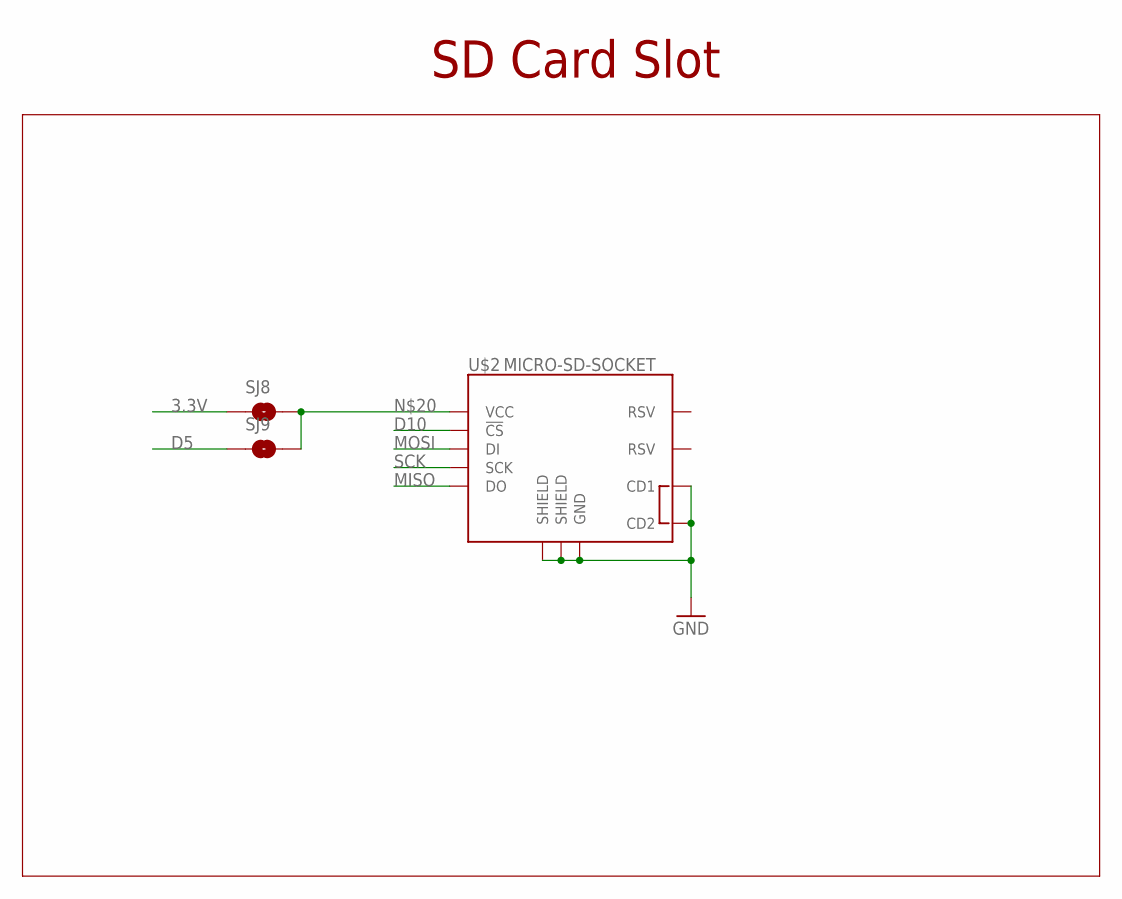
[picture p18: schematic LooSensorNodeV1.sch, sheet 3]

Parts:
SJ8, SJ9: SOLDERJUMPERNC; SJ_2S
U$2: MICRO-SD-SOCKET

Connections:
3.3V: SJ8.1; also elsewhere on the board
D5: SJ9.1; also elsewhere on the board
D10: U$2.CS (!CS); also elsewhere on the board
GND: U$2.CD1, U$2.CD2, U$2.GND, U$2.GND1 (SHIELD), U$2.GND3 (SHIELD); also elsewhere on the board
MISO: U$2.DO; also elsewhere on the board
MOSI: U$2.DI; also elsewhere on the board
unnamed 33: SJ8.2, SJ9.2, U$2.VCC; also elsewhere on the board
SCK: U$2.SCLK (SCK); also elsewhere on the board

Notes on the sheet:
SD Card Slot

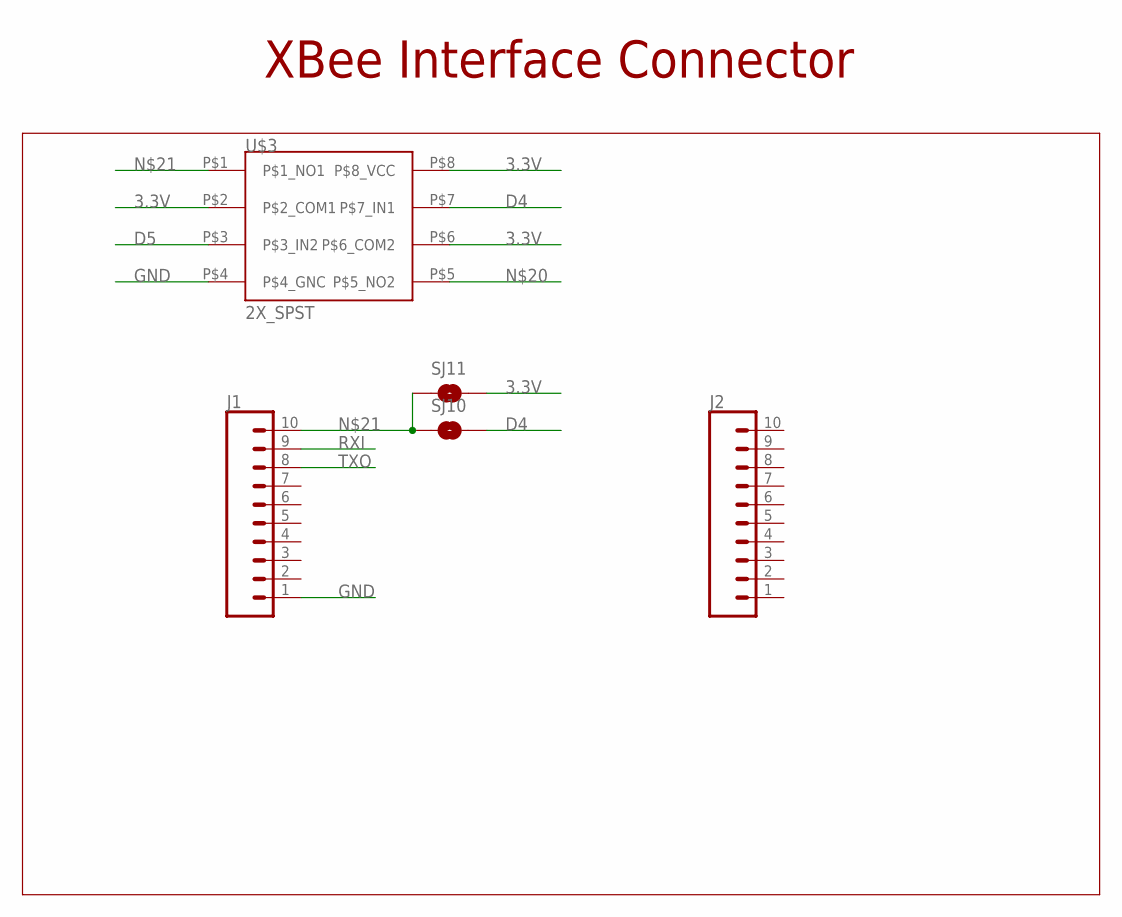
[picture p19: schematic LooSensorNodeV1.sch, sheet 4]

Parts:
J1, J2: CONN_102MM; 1X10-2MM
SJ10, SJ11: SOLDERJUMPERNC; SJ_2S
U$3: 2X_SPST

Connections:
3.3V: SJ11.2, U$3.P$2 (P$2_COM1), U$3.P$6 (P$6_COM2), U$3.P$8 (P$8_VCC); also elsewhere on the board
D4: SJ10.2, U$3.P$7 (P$7_IN1); also elsewhere on the board
D5: U$3.P$3 (P$3_IN2); also elsewhere on the board
GND: J1.1, U$3.P$4 (P$4_GNC); also elsewhere on the board
unnamed 33: U$3.P$5 (P$5_NO2); also elsewhere on the board
unnamed: J1.10, SJ10.1, SJ11.1, U$3.P$1 (P$1_NO1)
RXI: J1.9; also elsewhere on the board
TXO: J1.8; also elsewhere on the board

Notes on the sheet:
XBee Interface Connector

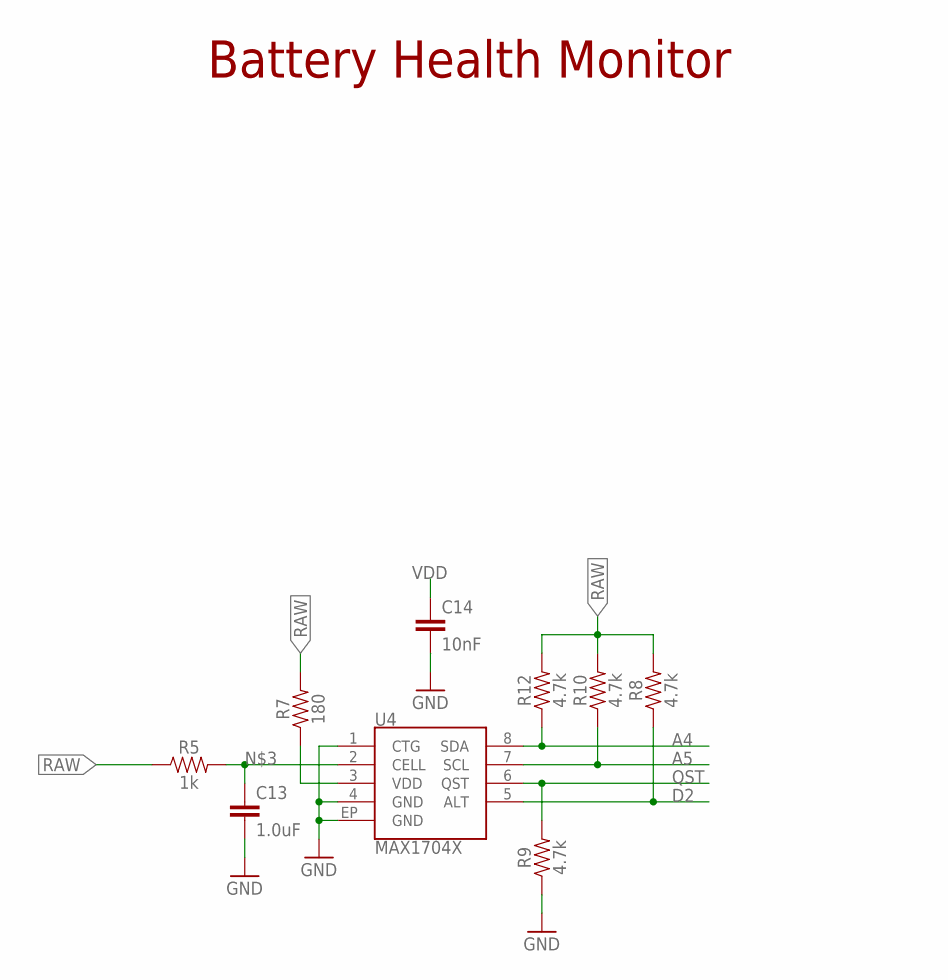
[picture p20: schematic LooSensorNodeV1.sch, sheet 5]

Parts:
C13: 1.0uF; 0603
C14: 10nF; 0603
R5: 1k; 0603
R7: 180; 0603
R8, R9, R10, R12: 4.7k; 0603
U4: MAX1704X; TDFN-8

Connections:
A4: R12.1, U4.8 (SDA); also elsewhere on the board
A5: R10.1, U4.7 (SCL); also elsewhere on the board
D2: R8.1, U4.5 (ALT); also elsewhere on the board
GND: C13.2, C14.2, R9.1, U4.1 (CTG), U4.4 (GND), U4.EP (GND); also elsewhere on the board
unnamed: C13.1, R5.2, U4.2 (CELL)
QST: R9.2, U4.6 (QST)
RAW: R5.1, R7.2, R8.2, R10.2, R12.2; also elsewhere on the board
VDD: C14.1, R7.1, U4.3 (VDD)

Notes on the sheet:
Battery Health Monitor

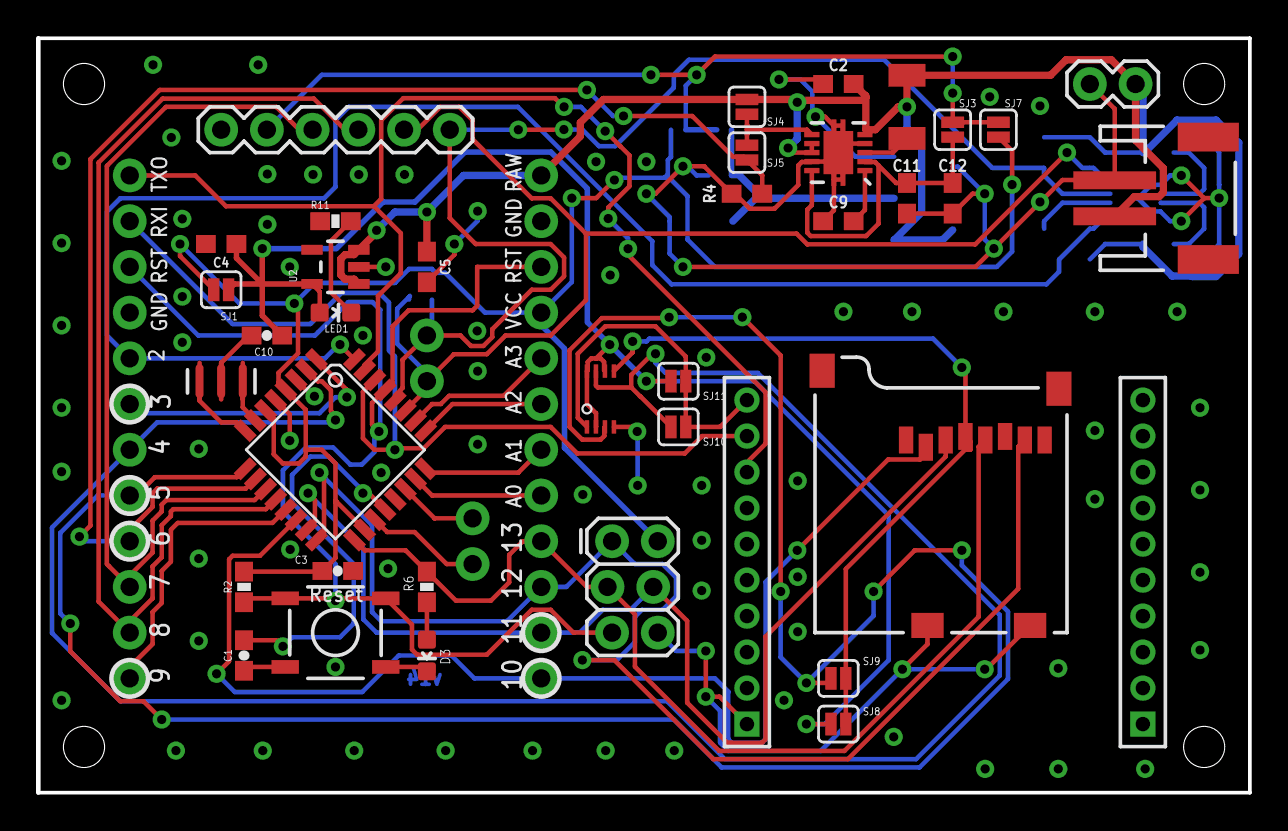
[picture p21: board LooSensorNodeV1.brd from above]

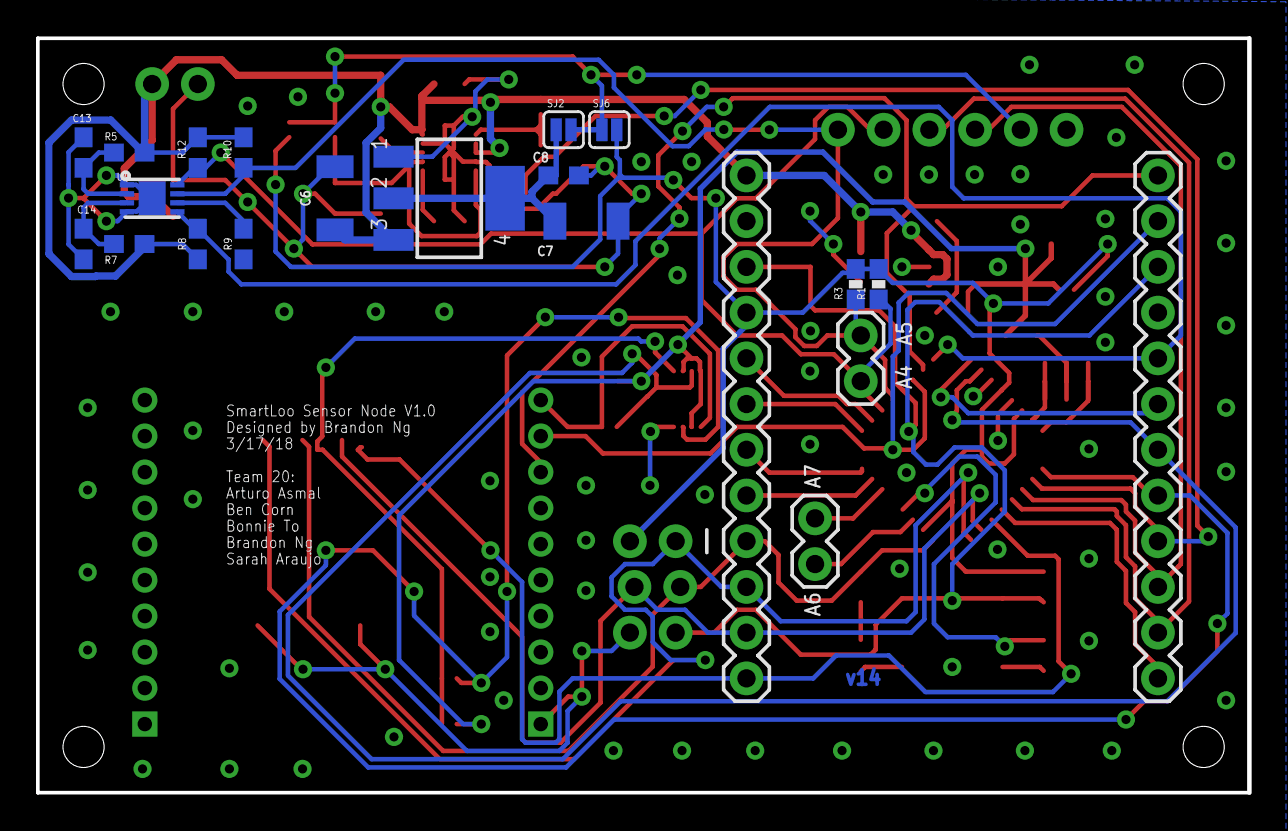
[picture p22: board LooSensorNodeV1.brd from below]

Board: 2 copper layers, 67.3 x 41.9 mm, 60 parts (21 on the bottom side), 43 nets.
