SmartLoo/HW/Resources/EAGLE/LooSensorNodeV0/LooSensorNodeV0.brd

## EAGLE design Resources/EAGLE/LooSensorNodeV0/LooSensorNodeV0.brd (continued)

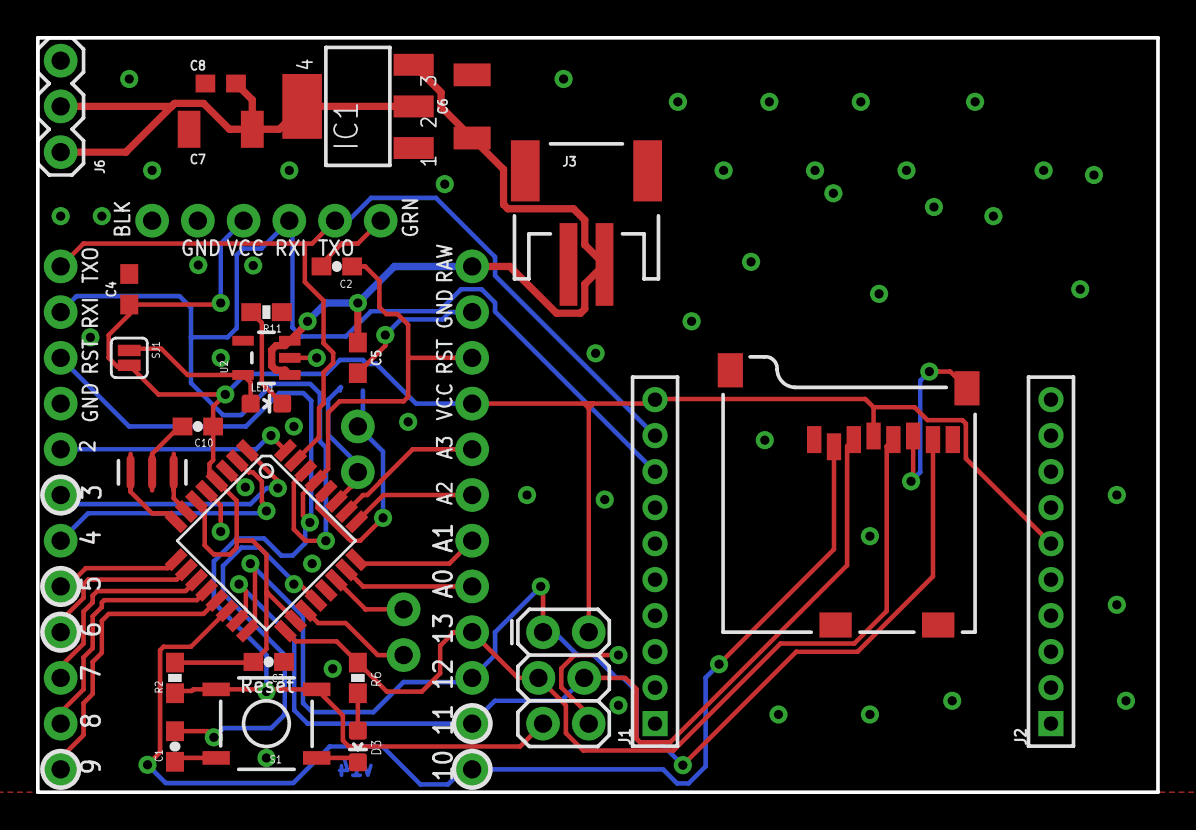
[picture p24: board LooSensorNodeV0.brd from above]

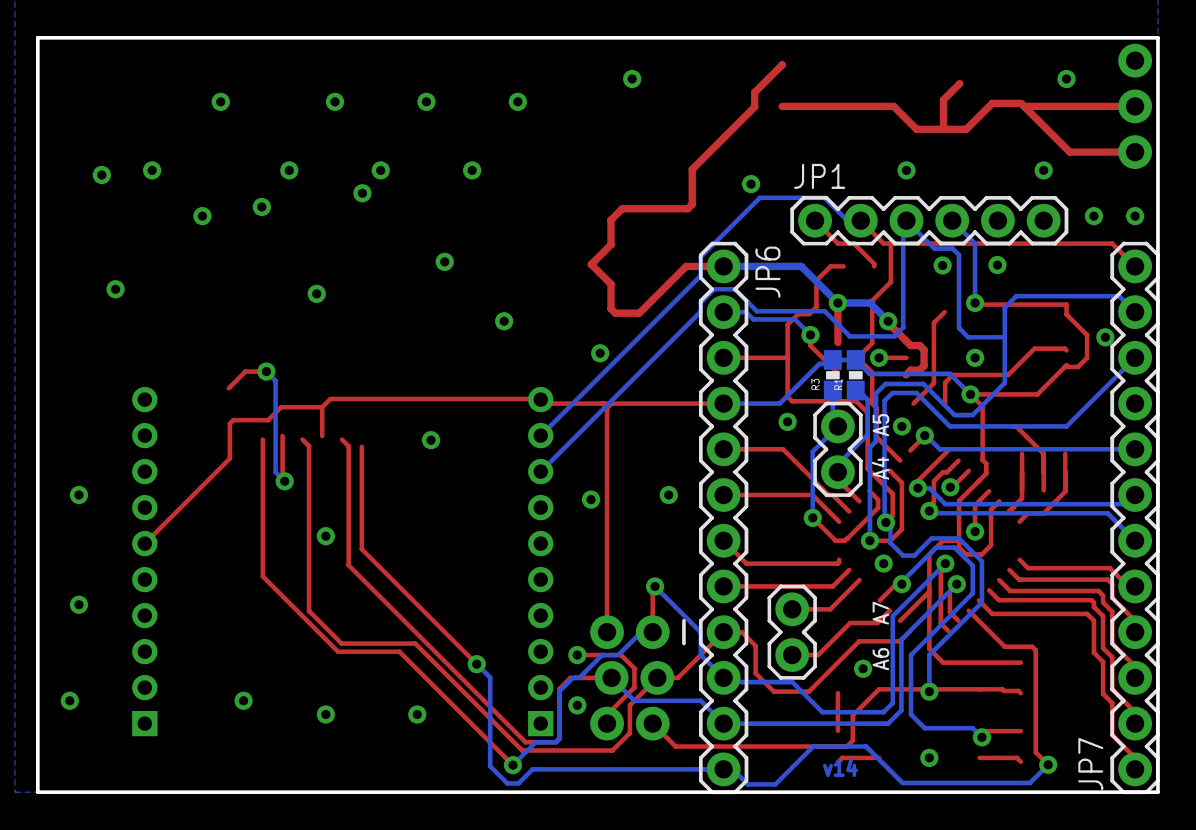
[picture p25: board LooSensorNodeV0.brd from below]

Board: 2 copper layers, 62.2 x 41.9 mm, 34 parts (7 on the bottom side), 34 nets.
