SmartLoo/HW/(commit log)

2018-02-07 String parsing for new format of data
    String parsing for GUID, Sensor Value, and Battery Level
2018-02-07 Update API endpoint for new sensor update
2018-02-11 XBee dedicated serial channel, error corrections
    [ESP8266toAPI.ino]
2018-04-01 commiting esp32 code as working.
    using D4 pin as TX , RX2 as RX.
2018-04-23 incorporated watch dog timer power optimization code
2018-04-26 change logic for when to check ultrasonic reading
2018-04-27 code cleanup and correct message format
    [ultrasonicSender.ino]
2018-04-27 code cleanup for water sensor code and introduced WDT optimization to water sensor code
2018-04-29 adding resource files
    [LooSensorNodeV0.brd, LooSensorNodeV0.sch, LooSensorNodeV1.brd, LooSensorNodeV1.sch, LooSensorNodeV2.brd, LooSensorNodeV2.sch]
2018-04-30 including BOM
    [SmartLooBOM.xlsx]
2018-05-03 update soap sensor timing
2018-05-04 Update esp32wifi.ino
    Updated to meet new database string format.
